timchpi/TinkerFET_release/Schematics.pdf

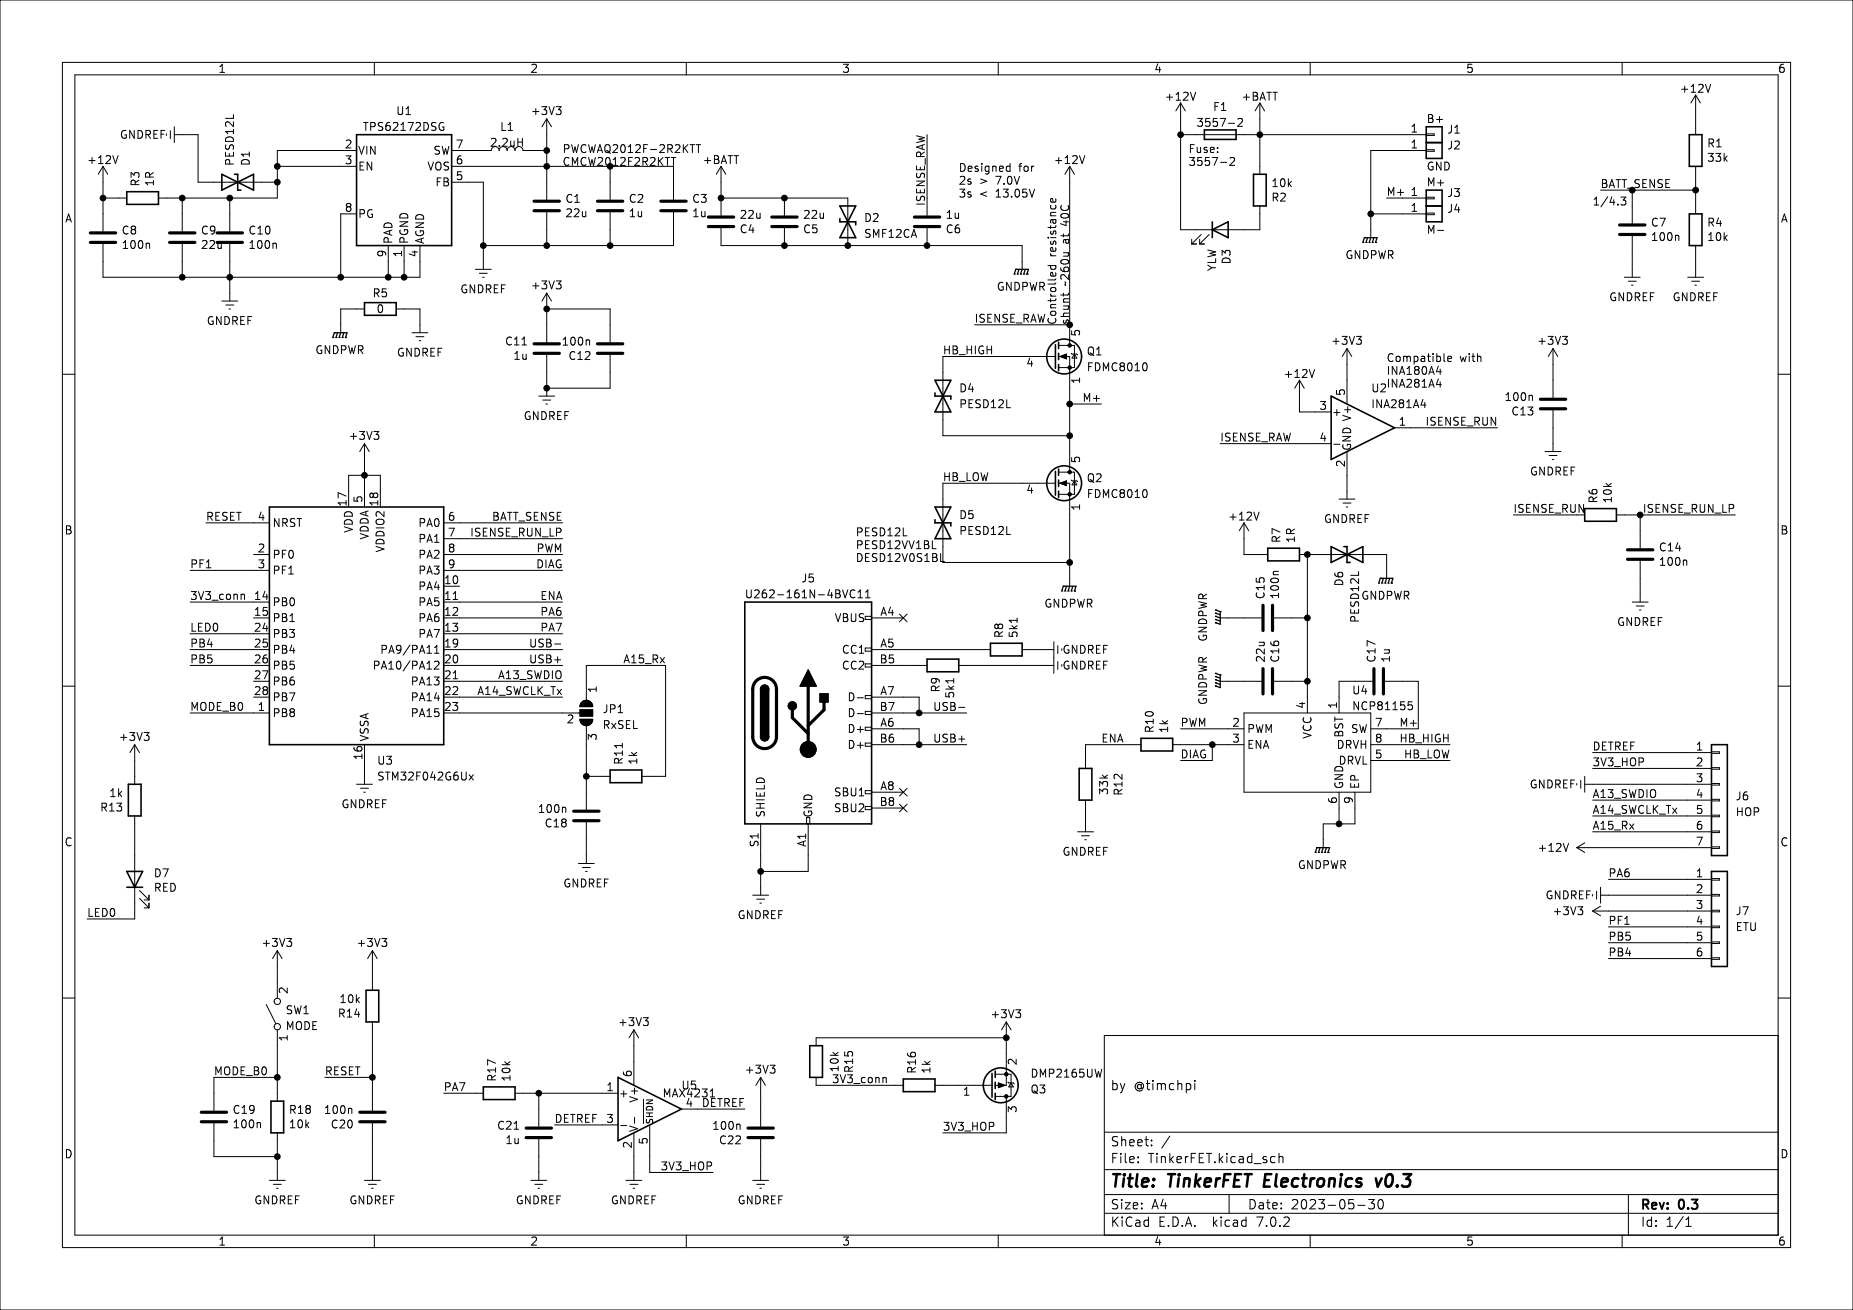
[picture p1: page 1]
