timchpi/TinkerFET_release/Inrush.asc

B1: bi; I={(30*(exp(V(n001)-19)))}
C1: cap; 7µ; Rser=0.005
C2: cap; 7µ; Rser=0.005
C3: cap; 7µ; Rser=0.001
C4: cap; 6.6µ; Rser=0.005
C5: cap; 5µ
C22: cap; 5µ
C23: cap; 5µ
C24: cap; 5µ
C25: cap; 5µ
D1: TVSdiode; SMAJ12CA
L1: ind; 300n; Rser=0.005
L2: ind; 300n; Rser=0.005
L3: ind; 200n; Rser=0.005
L12: ind; 300n; Rser=0.001
R1: res; 1
R2: res; 1
R11: res; 1
R12: res; 1
R13: res; 1
V1: voltage; PULSE(0 12.5 10m 1n 1n 1 2 1)
V2: voltage; PULSE(0 12.5 10m 1n 1n 1 2 1)
V3: voltage; PULSE(0 12.5 10m 1n 1n 1 2 1)
V12: voltage; PULSE(0 13.1 10m 1n 1n 4u 5u 20)
Named nets: 0
.tran 0 12m 0 200n startup
.include tvs_diode_smajxxx_ca.spice.txt
https://www.littelfuse.com/technical-resources/~/media/Electronics_Technical/SPICE_Models/TVS_Diode/TVS_Diode_SMAJxxx_CA_SPICE_Model_txt.txt
