timchpi/TinkerFET_release/(commit log)

2023-05-27 v0.3 Source release
    [TinkerFET.kicad_pcb, TinkerFET.kicad_sch]
2023-05-29 Updated topside capacitors for easier manual assembly
    [TinkerFET.kicad_pcb, TinkerFET.kicad_sch]
2023-05-31 Updated tracer logic level supply FET part
    [TinkerFET.kicad_pcb, TinkerFET.kicad_sch]
2023-05-31 Updated front side components
    To reduce number of different parts needed
    [TinkerFET.kicad_pcb, TinkerFET.kicad_sch]
2023-06-11 Corrected schematic comment
    [TinkerFET.kicad_sch]
2023-06-23 Made minor update to 3557-2 footprint, added library file
    [TinkerFET.kicad_pcb]
